keenedge/SMT_Class/pcb-art/labrador-ornament/preview.png

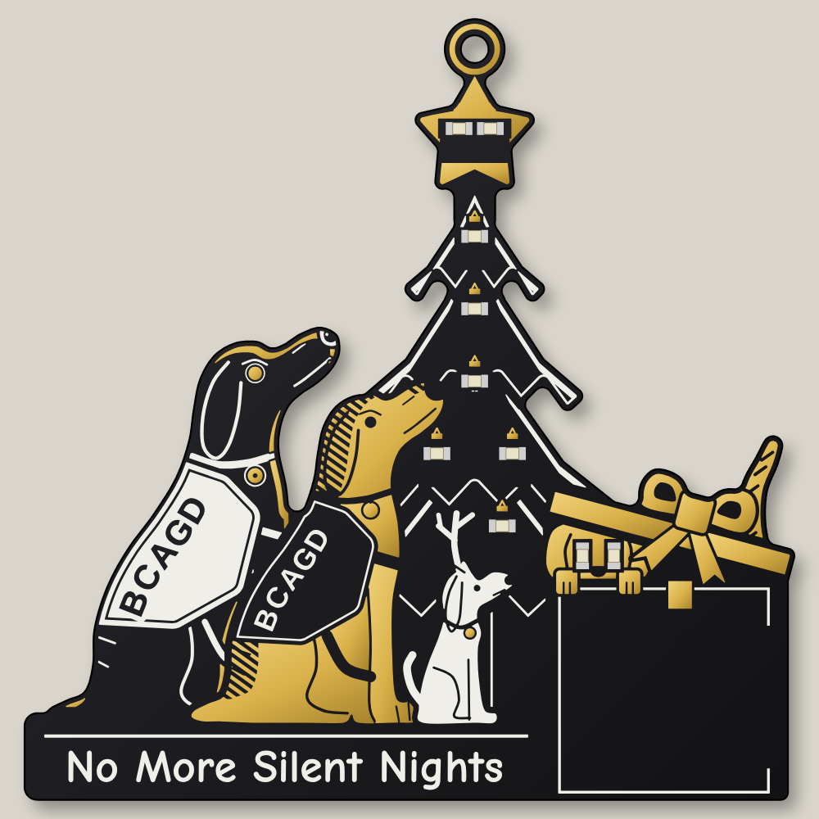
pcb-art/labrador-ornament/preview.png
