keenedge/SMT_Class/pcb-art/labrador-ornament/preview_pcb_layout.png

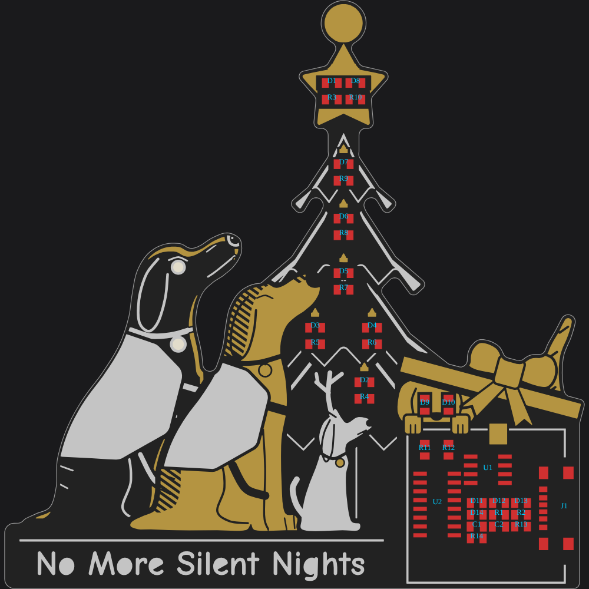
pcb-art/labrador-ornament/preview_pcb_layout.png
