keenedge/SMT_Class/pcb-art/labrador-ornament/preview_stages.png

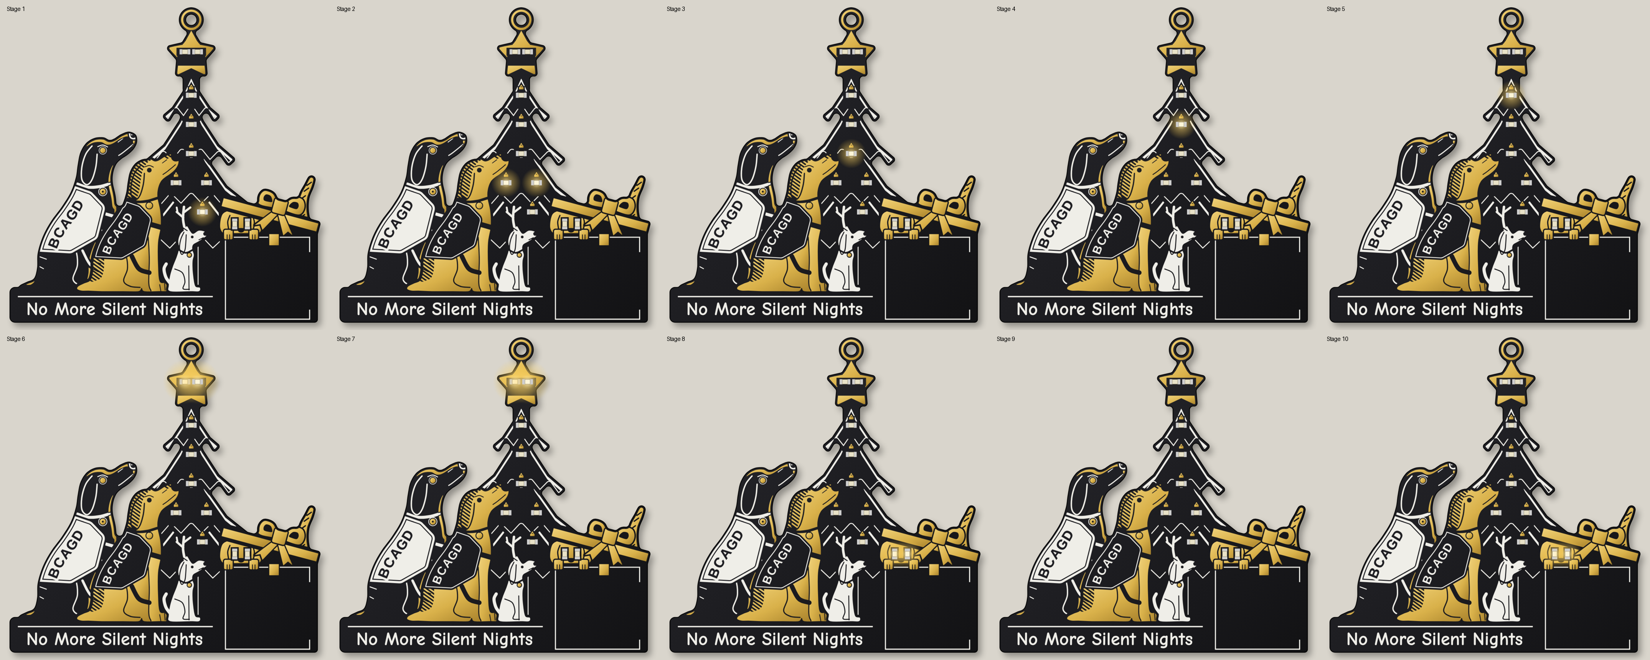
pcb-art/labrador-ornament/preview_stages.png
