keenedge/SMT_Class/smt_tree.kicad_pcb

## KiCad design smt_tree.kicad_pcb (2026-11-14)

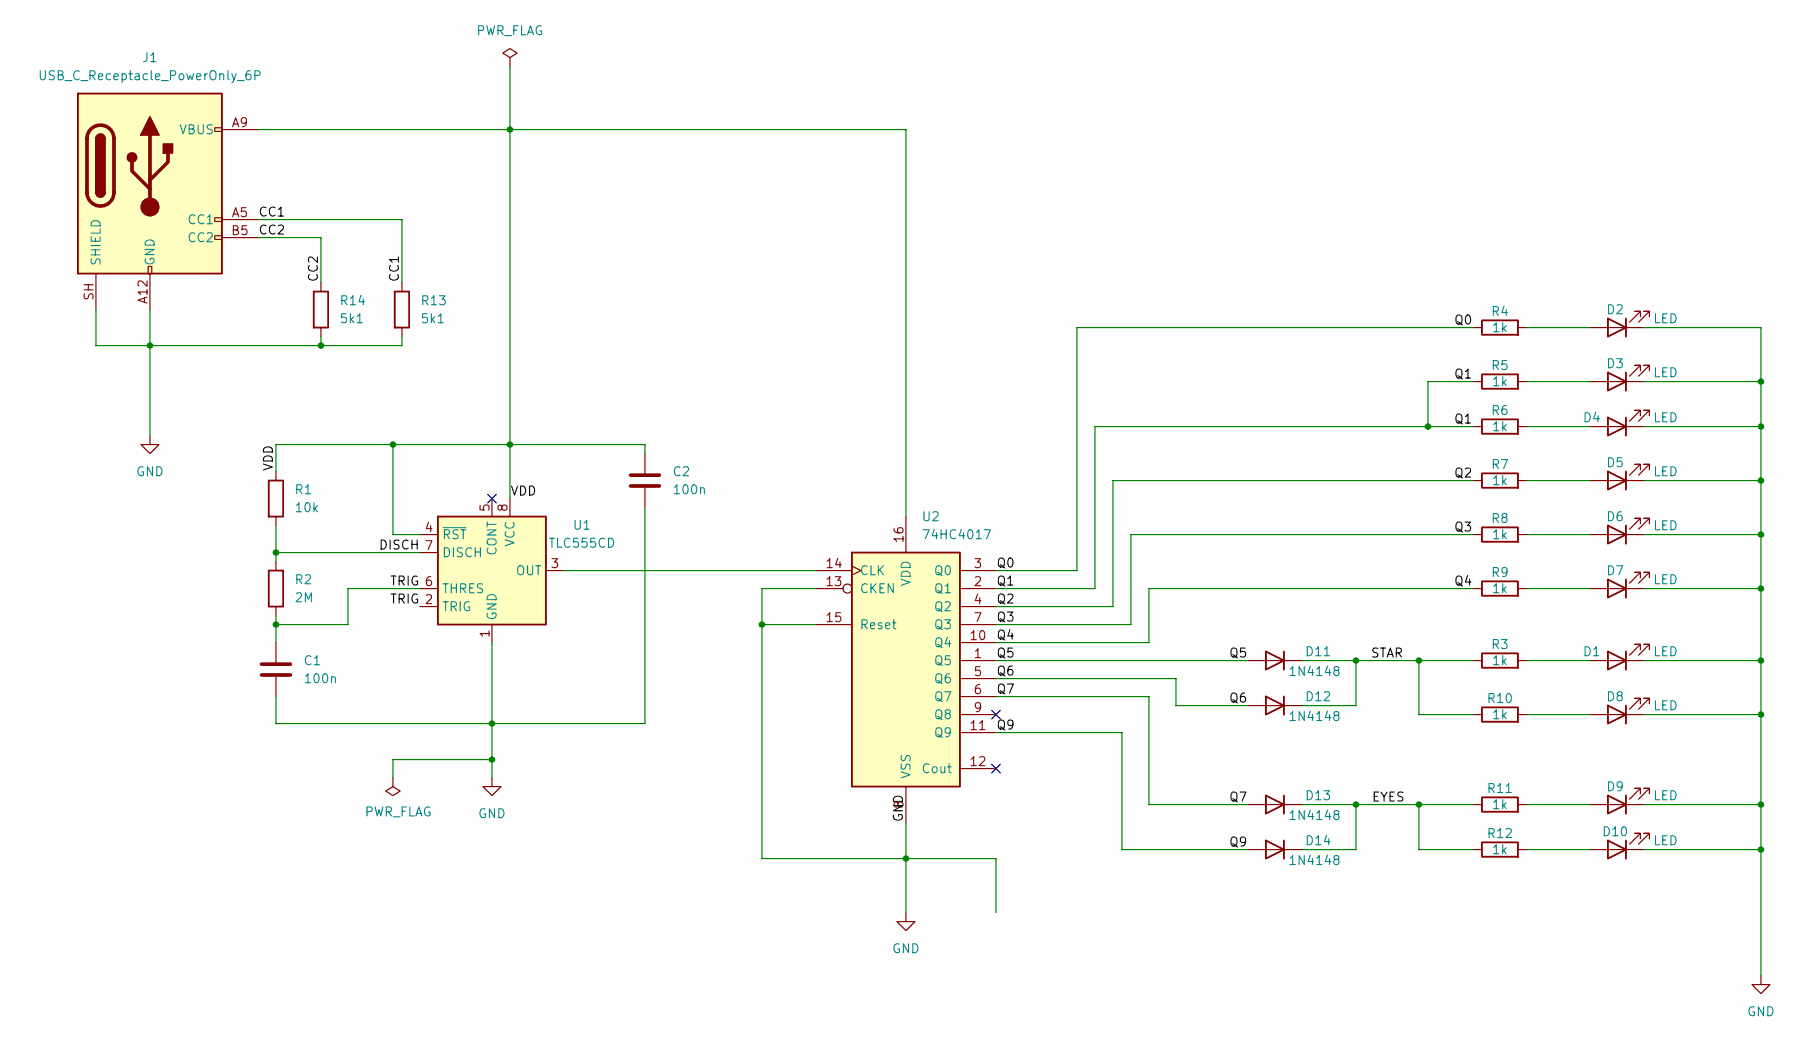
[picture p4: schematic smt_tree.kicad_sch]

Parts:
C1, C2: 100n; C_0805_2012Metric
D1, D2, D3, D4, D5, D6, D7, D8, D9, D10: LED; LED_0805_2012Metric
D11, D12, D13, D14: 1N4148; D_0805_2012Metric
J1: USB_C_Receptacle_PowerOnly_6P; USB_C_Receptacle_GCT_USB4135-GF-A_6P_TopMnt_Horizontal
R1: 10k; R_0805_2012Metric
R2: 2M; R_0805_2012Metric
R3, R4, R5, R6, R7, R8, R9, R10, R11, R12: 1k; R_0805_2012Metric
R13, R14: 5k1; R_0805_2012Metric
U1: TLC555CD; SOIC-8_3.9x4.9mm_P1.27mm
U2: 74HC4017; SOIC-16_3.9x9.9mm_P1.27mm

Connections:
/CC1: J1.A5 (CC1), R13.1
/CC2: J1.B5 (CC2), R14.1
/DISCH: R1.2, R2.2, U1.7 (DISCH)
/EYES: D13.1 (K), D14.1 (K), R11.1, R12.1
/Q0: R4.1, U2.3 (Q0)
/Q1: R5.1, R6.1, U2.2 (Q1)
/Q2: R7.1, U2.4 (Q2)
/Q3: R8.1, U2.7 (Q3)
/Q4: R9.1, U2.10 (Q4)
/Q5: D11.2 (A), U2.1 (Q5)
/Q6: D12.2 (A), U2.5 (Q6)
/Q7: D13.2 (A), U2.6 (Q7)
/Q9: D14.2 (A), U2.11 (Q9)
/STAR: D11.1 (K), D12.1 (K), R3.1, R10.1
/TRIG: C1.1, R2.1, U1.2 (TRIG), U1.6 (THRES)
/VDD: C2.1, J1.A9 (VBUS), J1.B9 (VBUS), R1.1, U1.4 (~RST), U1.8 (VCC), U2.16 (VDD)
GND: C1.2, C2.2, D1.1 (K), D2.1 (K), D3.1 (K), D4.1 (K), D5.1 (K), D6.1 (K), D7.1 (K), D8.1 (K), D9.1 (K), D10.1 (K), J1.A12 (GND), J1.B12 (GND), J1.SH (SHIELD), R13.2, R14.2, U1.1 (GND), U2.8 (VSS), U2.13 (CKEN), U2.15 (Reset)
unnamed: D1.2 (A), R3.2
unnamed: D2.2 (A), R4.2
unnamed: D3.2 (A), R5.2
unnamed: D4.2 (A), R6.2
unnamed: D5.2 (A), R7.2
unnamed: D6.2 (A), R8.2
unnamed: D7.2 (A), R9.2
unnamed: D8.2 (A), R10.2
unnamed: D9.2 (A), R11.2
unnamed: D10.2 (A), R12.2
unnamed: U1.3 (OUT), U2.14 (CLK)

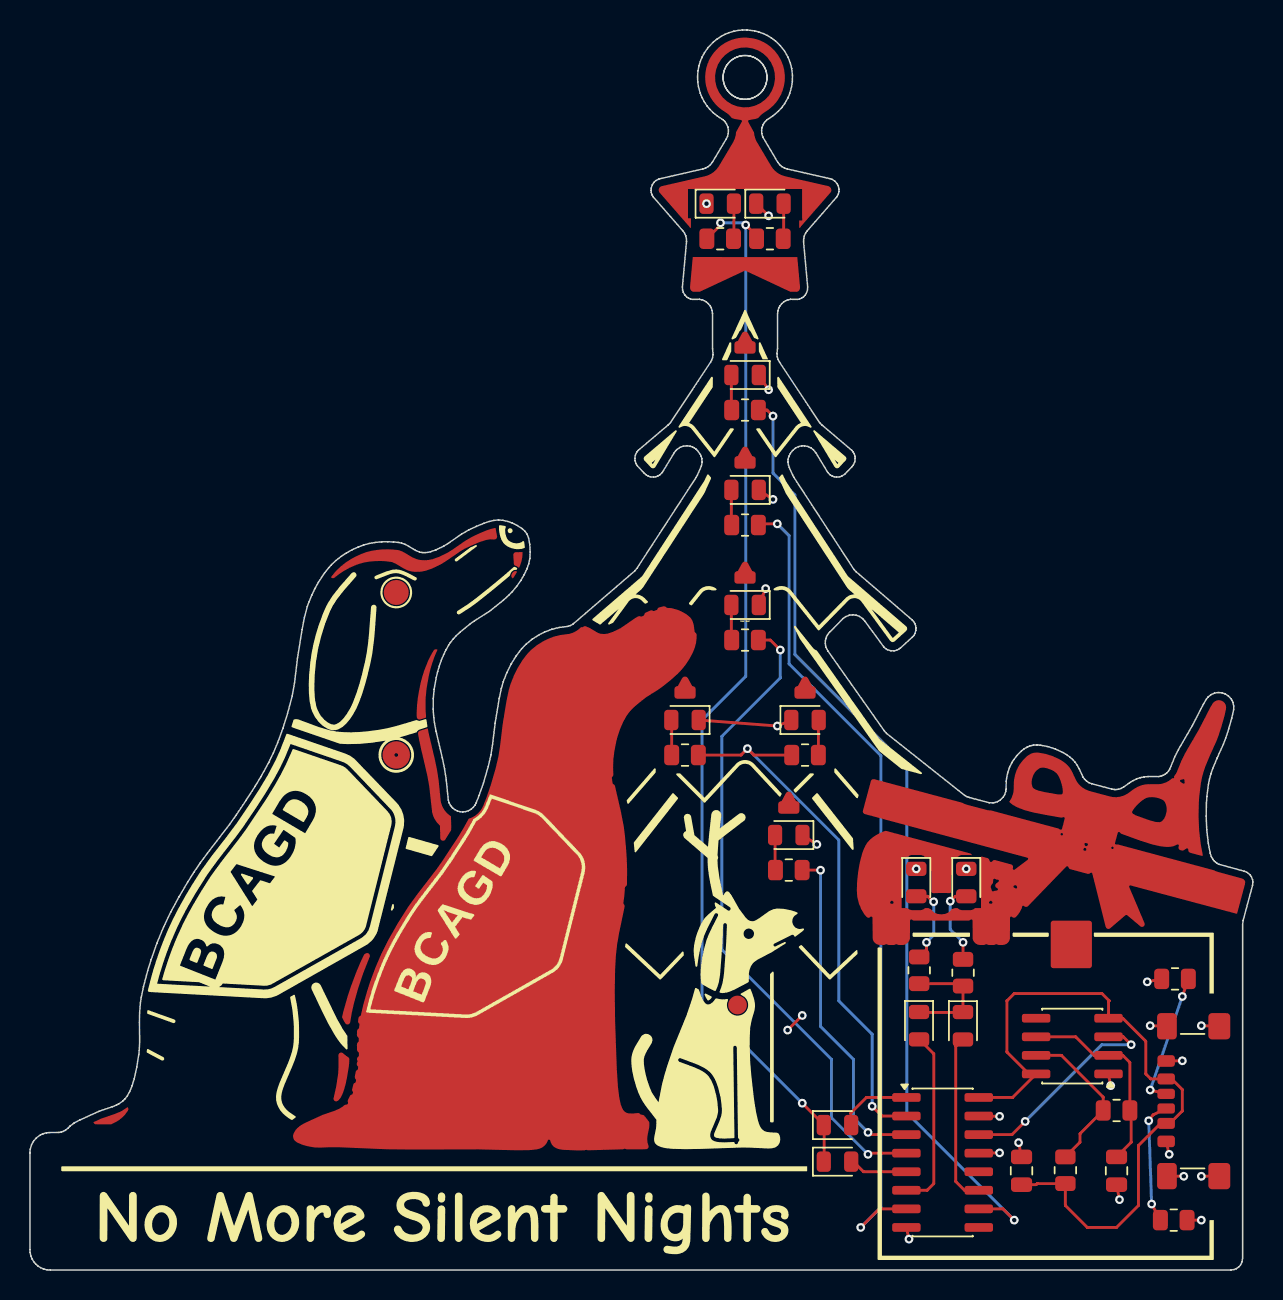
[picture p5: board smt_tree.kicad_pcb from above]

Board: 2 copper layers, 83.7 x 84.8 mm, 33 parts (0 on the bottom side), 28 nets.
