keenedge/SMT_Class/(commit log)

2026-11-13 First Tree
    [smt_tree.kicad_pcb, smt_tree.kicad_sch]
2026-11-13 Add Silent Night Labrador ornament PCB art layers
    Claude-Session: https://claude.ai/code/session_01LWeVxTjGJUc5PEY3V1Ku58
2026-11-13 Rework Labrador ornament as noir art with the 10 smt_tree LEDs
    The star is now the single light source: hard light shafts, silhouetted
    dog and tree, gold rim light. D1-D9 are tree baubles and D10 sits in the
    star, so the 4017 chase climbs the tree. Adds LED guide layer, XY list,
    lit preview and a bottom flat for the USB-C connector.
    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
2026-11-13 Cut the ornament board as a two-dog and tree silhouette
    The board outline is now a black Labrador and a yellow Labrador looking
    up at the tree and star, joined by a ground strip. LED positions, art
    layers, previews and README are regenerated for the new shape.
    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
2026-11-13 Shrink the ornament to fit 85 x 85 mm and rebalance
    The scene is scaled to 83.3 x 85.0 mm while LEDs, the coin cell and the
    hanging hole stay at real size. The tree and hang point move so the
    lighter board still balances against the 4.5 g battery assembly.
    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
2026-11-13 Move the ten LEDs to the tree, star, dogs and puppy eyes
    Four on the tree, one in the star, one on each of the three dogs and
    one for each of the puppy's eyes.
    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
2026-11-13 Fix JLCPCB design-rule issues and add a manufacturability review
    Moves the gold eyelet ring 0.55 mm away from the hanging hole, keeps
    LED pads at least 0.25 mm from art copper, closes sub-0.1 mm copper gaps,
    thickens hairlines in the caption and re-picks the coin cell position.
    The build script now prints the design-rule check.
    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
2026-11-13 Ornament: 10-stage LED plan (7 tree in 5 groups, star, puppy eyes)
    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
2026-11-13 Ornament: front SMT parts zone in gift box, through-hole holder pads
    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
2026-11-13 Ornament: USB-C only power, no cell; rebalance hang point, all SMT on front
    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
2026-11-13 Ornament: new schematic (10-stage, USB-C, TLC555/74HC4017) and placed PCB with art layers
    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
    [smt_tree.kicad_pcb, smt_tree.kicad_sch]
2026-11-13 Ornament: place series resistors next to their LEDs
    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
    [smt_tree.kicad_pcb]
2026-11-13 Ornament: two star LEDs, resistors below LEDs, USB-C on the right, nose silkscreen, Comic Neue slogan
    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
    [smt_tree.kicad_pcb, smt_tree.kicad_sch]
2026-11-13 Schematic: put generated symbols on the 1.27 mm grid so wires snap to pins
    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
    [smt_tree.kicad_pcb, smt_tree.kicad_sch]
2026-11-13 Add DRC-clean board copy (J1 pads, art clearance, GND pour, footprint updates)
    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
    [smt_tree_drcfix.kicad_pcb]
2026-11-14 Tab markers and panel
    [smt_tree.kicad_pcb, smt_tree.kicad_sch, smt_tree_with_frame.kicad_pcb]
